aruna-rov/Apsu/schematic/wire/wire.png

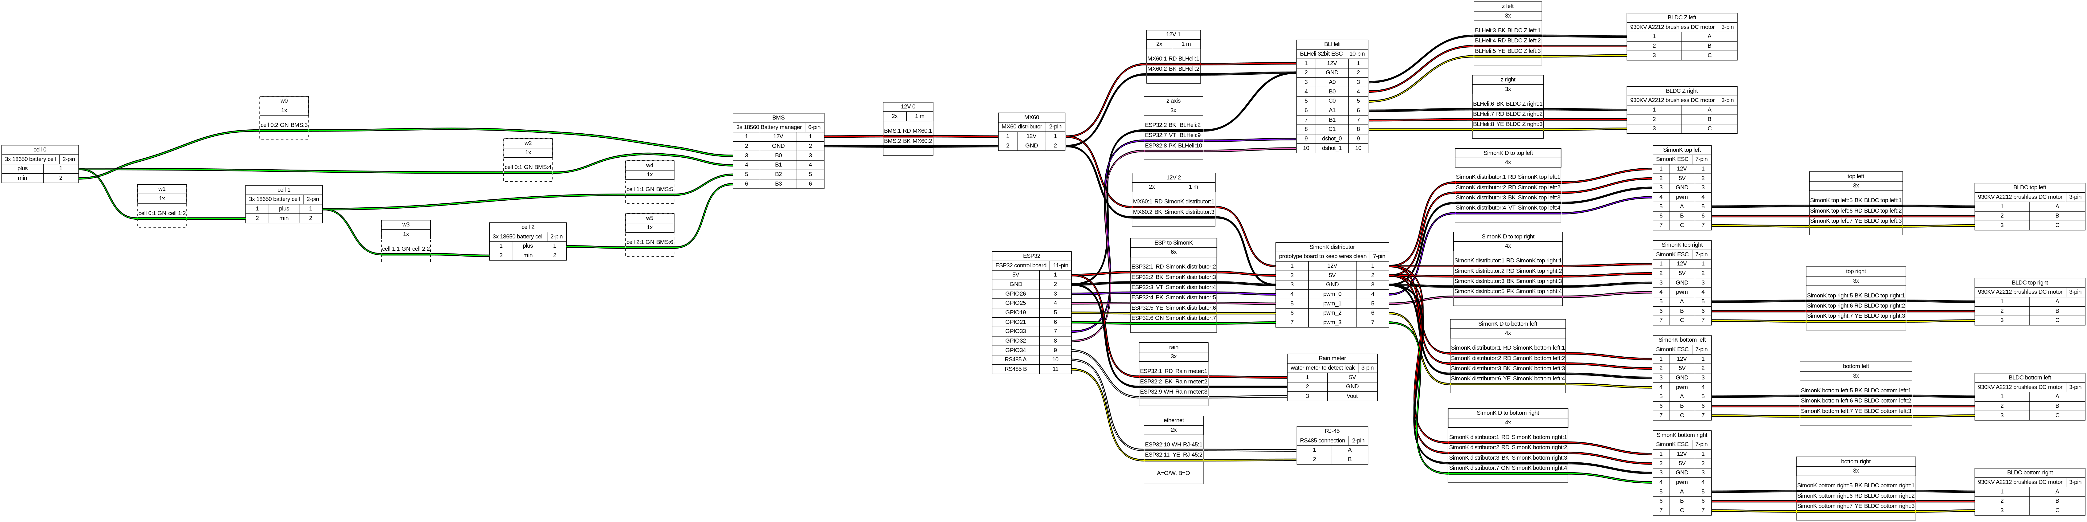
schematic/wire/wire.png
