aruna-rov/Apsu/(list of files, cad)

Other CAD files:
schematic/pcb_design/pcb_design.FCStd
