aruna-rov/Apsu/schematic/Apsu.kicad_pcb

## KiCad design schematic/Apsu.kicad_pcb (2020-08-03)

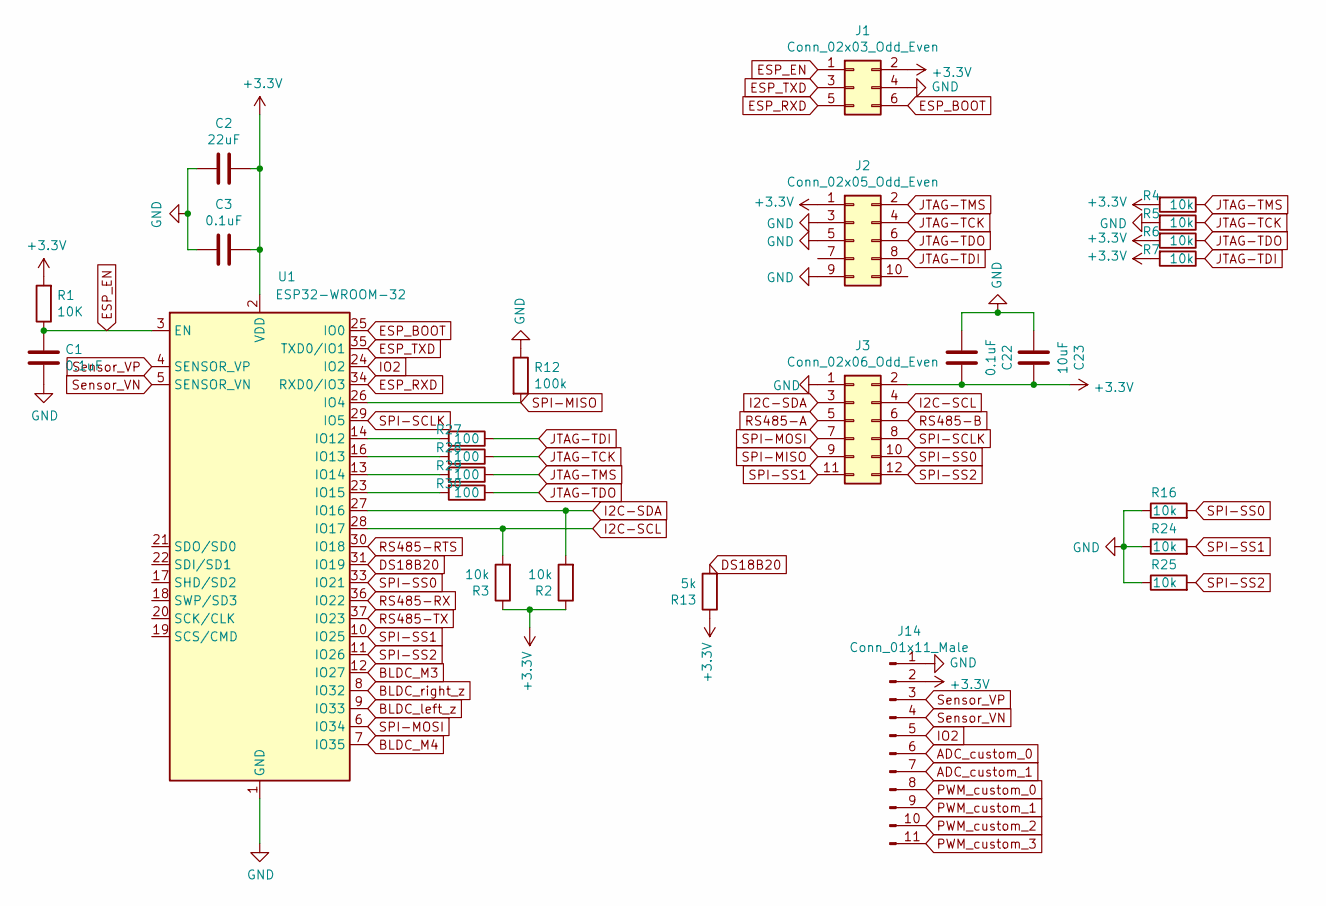
[picture p2: schematic ESP32_module.sch]

Parts:
C1, C3, C22: 0.1uF; C_0805_2012Metric_Pad1.15x1.40mm_HandSolder; MPN C0805C104J5RACTU
C2: 22uF; C_0805_2012Metric_Pad1.15x1.40mm_HandSolder; MPN C0805C226K9PACTU
C23: 10uF; C_0805_2012Metric_Pad1.15x1.40mm_HandSolder; MPN C0805C106K8PACTU
J1: Conn_02x03_Odd_Even; PinHeader_2x03_P1.27mm_Vertical_IDC; MPN GRPB032VWVN-RC
J2: Conn_02x05_Odd_Even; 10pin1.27mmIDC; MPN 3220-10-0100-00
J3: Conn_02x06_Odd_Even; IDC-Header_2x06_P2.54mm_Vertical; MPN BHR-12-VUA
J14: Conn_01x11_Male; PinHeader_1x11_P2.54mm_Vertical
R1: 10K; R_0805_2012Metric_Pad1.15x1.40mm_HandSolder; MPN ERA-6AEB103V
R2, R3, R4, R5, R6, R7, R16, R24, R25: 10k; R_0805_2012Metric_Pad1.15x1.40mm_HandSolder; MPN ERA-6AEB103V
R12: 100k; R_0805_2012Metric_Pad1.15x1.40mm_HandSolder; MPN ERA-6AEB104V
R13: 5k; R_0805_2012Metric_Pad1.15x1.40mm_HandSolder; MPN ERA6AEB4991V
R27, R28, R29, R30: 100; R_0805_2012Metric_Pad1.15x1.40mm_HandSolder; MPN ERA6AEB101V
U1: ESP32-WROOM-32; MPN ESP32-WROOM-32D

Connections:
+3V3: C2.2, C3.2, C22.2, C23.2, J1.2, J2.1, J3.2, J14.2, R1.2, R2.1, R3.1, R4.2, R6.2, R7.2, R13.1, U1.2 (VDD); also elsewhere on the board
ADC_custom_0: J14.6; also elsewhere on the board
ADC_custom_1: J14.7; also elsewhere on the board
BLDC_M3: U1.12 (IO27); also elsewhere on the board
BLDC_M4: U1.7 (IO35); also elsewhere on the board
BLDC_left_z: U1.9 (IO33); also elsewhere on the board
BLDC_right_z: U1.8 (IO32); also elsewhere on the board
DS18B20: R13.2, U1.31 (IO19); also elsewhere on the board
ESP_BOOT: J1.6, U1.25 (IO0)
ESP_EN: C1.1, J1.1, R1.1, U1.3 (EN)
ESP_RXD: J1.5, U1.34 (RXD0/IO3)
ESP_TXD: J1.3, U1.35 (TXD0/IO1)
GND: C1.2, C2.1, C3.1, C22.1, C23.1, J1.4, J2.3, J2.5, J2.9, J3.1, J14.1, R5.2, R12.1, R16.1, R24.1, R25.1, U1.1 (GND), U1.15 (GND), U1.38 (GND), U1.39 (GND); also elsewhere on the board
I2C-SCL: J3.4, R3.2, U1.28 (IO17); also elsewhere on the board
I2C-SDA: J3.3, R2.2, U1.27 (IO16); also elsewhere on the board
IO2: J14.5, U1.24 (IO2)
JTAG-TCK: J2.4, R5.1, R28.1
JTAG-TDI: J2.8, R7.1, R27.1
JTAG-TDO: J2.6, R6.1, R30.1
JTAG-TMS: J2.2, R4.1, R29.1
unnamed: R27.2, U1.14 (IO12)
unnamed: R28.2, U1.16 (IO13)
unnamed: R29.2, U1.13 (IO14)
unnamed: R30.2, U1.23 (IO15)
PWM_custom_0: J14.8; also elsewhere on the board
PWM_custom_1: J14.9; also elsewhere on the board
PWM_custom_2: J14.10; also elsewhere on the board
PWM_custom_3: J14.11; also elsewhere on the board
RS485-A: J3.5; also elsewhere on the board
RS485-B: J3.6; also elsewhere on the board
RS485-RTS: U1.30 (IO18); also elsewhere on the board
RS485-RX: U1.36 (IO22); also elsewhere on the board
RS485-TX: U1.37 (IO23); also elsewhere on the board
SPI-MISO: J3.9, R12.2, U1.26 (IO4); also elsewhere on the board
SPI-MOSI: J3.7, U1.6 (IO34)
SPI-SCLK: J3.8, U1.29 (IO5); also elsewhere on the board
SPI-SS0: J3.10, R16.2, U1.33 (IO21); also elsewhere on the board
SPI-SS1: J3.11, R24.2, U1.10 (IO25); also elsewhere on the board
SPI-SS2: J3.12, R25.2, U1.11 (IO26); also elsewhere on the board
Sensor_VN: J14.4, U1.5 (SENSOR_VN)
Sensor_VP: J14.3, U1.4 (SENSOR_VP)

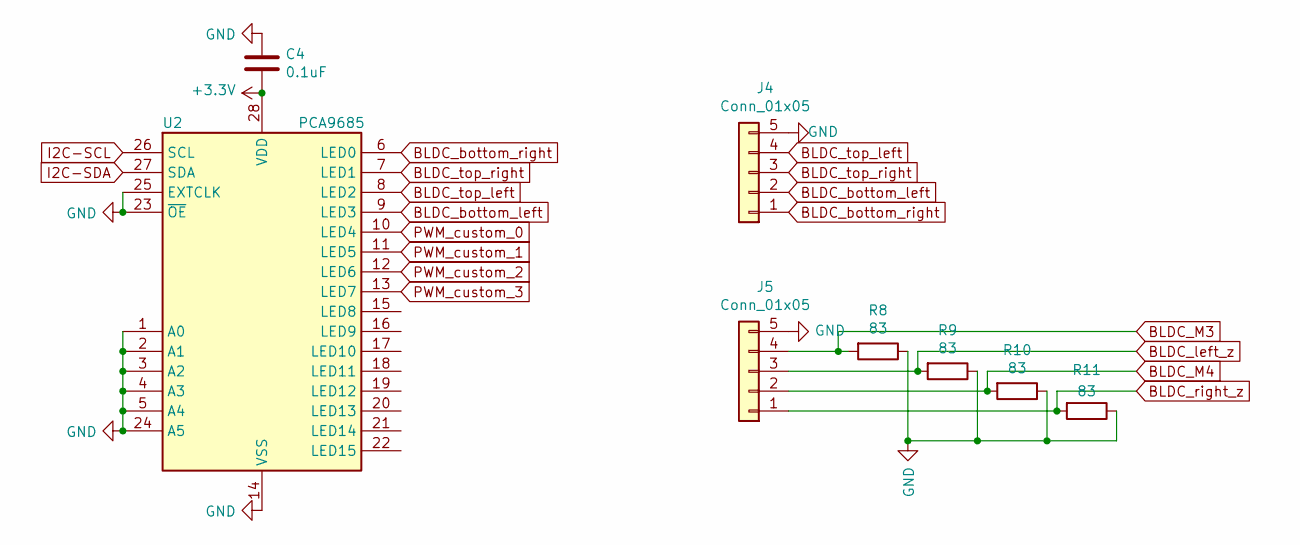
[picture p3: schematic moter.sch]

Parts:
C4: 0.1uF; C_0805_2012Metric_Pad1.15x1.40mm_HandSolder; MPN C0805C104J5RACTU
J4, J5: Conn_01x05; JST_XH_B5B-XH-A_1x05_P2.50mm_Vertical; MPN B5B-XH-A(LF)(SN)
R8, R9, R10, R11: 83; R_0805_2012Metric_Pad1.15x1.40mm_HandSolder; MPN ERA-6AEB820V
U2: PCA9685; NXP_Semiconductors-SOT788-1-02_2016-0-MFG; MPN PCA9685BS,118

Connections:
+3V3: C4.2, U2.28 (VDD); also elsewhere on the board
BLDC_M3: J5.4, R8.2; also elsewhere on the board
BLDC_M4: J5.2, R10.2; also elsewhere on the board
BLDC_bottom_left: J4.2, U2.9 (LED3)
BLDC_bottom_right: J4.1, U2.6 (LED0)
BLDC_left_z: J5.3, R9.2; also elsewhere on the board
BLDC_right_z: J5.1, R11.2; also elsewhere on the board
BLDC_top_left: J4.4, U2.8 (LED2)
BLDC_top_right: J4.3, U2.7 (LED1)
GND: C4.1, J4.5, J5.5, R8.1, R9.1, R10.1, R11.1, U2.1 (A0), U2.2 (A1), U2.3 (A2), U2.4 (A3), U2.5 (A4), U2.14 (VSS), U2.23 (~OE), U2.24 (A5), U2.25 (EXTCLK); also elsewhere on the board
I2C-SCL: U2.26 (SCL); also elsewhere on the board
I2C-SDA: U2.27 (SDA); also elsewhere on the board
PWM_custom_0: U2.10 (LED4); also elsewhere on the board
PWM_custom_1: U2.11 (LED5); also elsewhere on the board
PWM_custom_2: U2.12 (LED6); also elsewhere on the board
PWM_custom_3: U2.13 (LED7); also elsewhere on the board

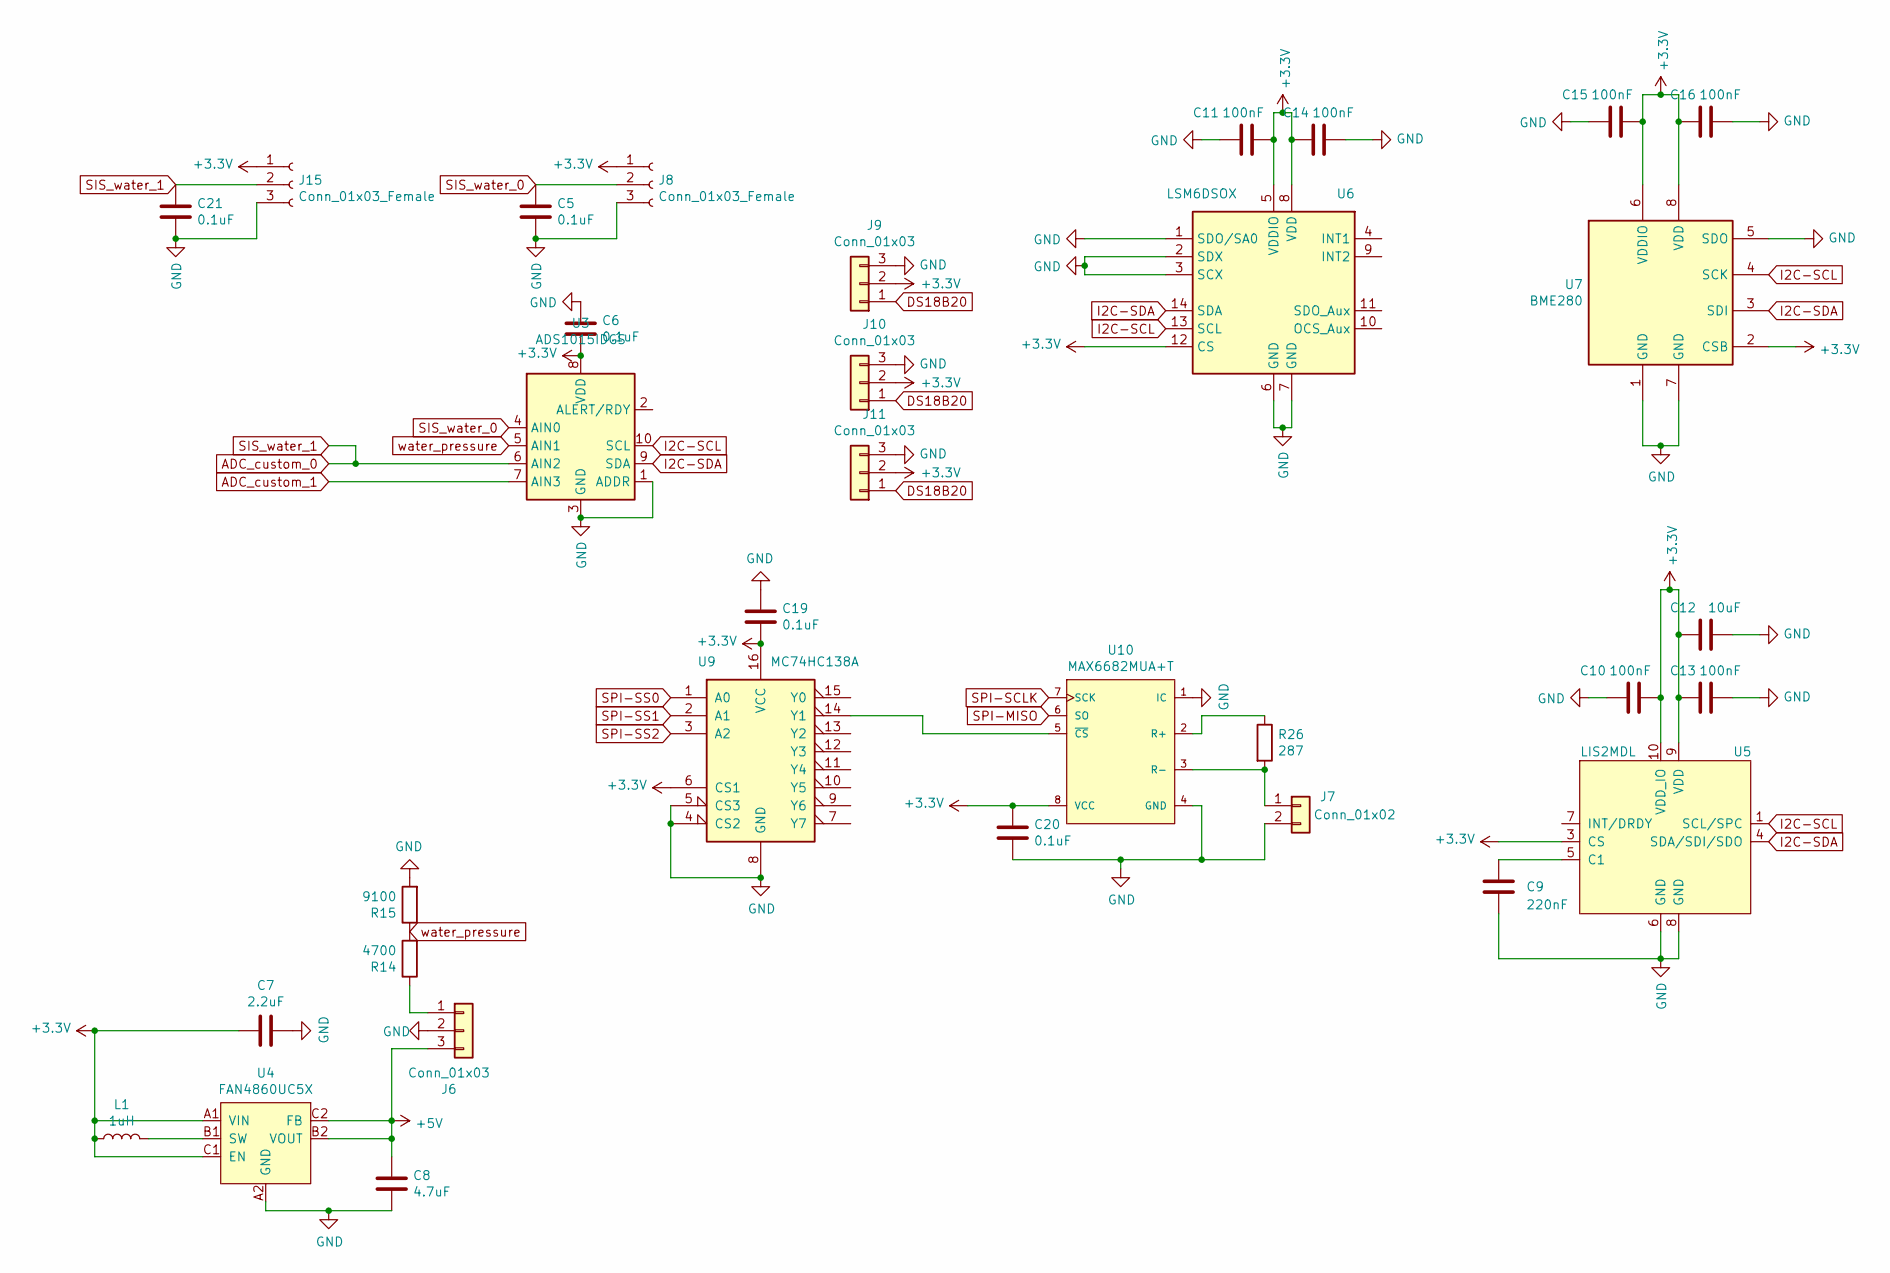
[picture p4: schematic sensors.sch]

Parts:
C5, C6, C19, C20, C21: 0.1uF; C_0805_2012Metric_Pad1.15x1.40mm_HandSolder; MPN C0805C104J5RACTU
C7: 2.2uF; C_0805_2012Metric_Pad1.15x1.40mm_HandSolder; MPN C0805C225K4RACTU
C8: 4.7uF; C_0805_2012Metric_Pad1.15x1.40mm_HandSolder; MPN C0805C475K3PACTU
C9: 220nF; C_0805_2012Metric_Pad1.15x1.40mm_HandSolder; MPN C0805C224K5RACTU
C10, C11, C13, C14, C15, C16: 100nF; C_0805_2012Metric_Pad1.15x1.40mm_HandSolder; MPN C0805C104J5RACTU
C12: 10uF; C_0805_2012Metric_Pad1.15x1.40mm_HandSolder; MPN C0805C106K8PACTU
J6, J9, J10, J11: Conn_01x03; JST_XH_B3B-XH-A_1x03_P2.50mm_Vertical; MPN B3B-XH-A(LF)(SN)
J7: Conn_01x02; JST_XH_B2B-XH-A_1x02_P2.50mm_Vertical; MPN B2B-XH-A(LF)(SN)
J8, J15: Conn_01x03_Female; JST_XH_B3B-XH-A_1x03_P2.50mm_Vertical; MPN B3B-XH-A(LF)(SN)
L1: 1uH; L_0805_2012Metric_Pad1.15x1.40mm_HandSolder; MPN LQM21NN1R0K10D
R14: 4700; R_0805_2012Metric_Pad1.15x1.40mm_HandSolder; MPN ERA-6AEB472V
R15: 9100; R_0805_2012Metric_Pad1.15x1.40mm_HandSolder; MPN ERA6AEB912V
R26: 287; R_0805_2012Metric_Pad1.15x1.40mm_HandSolder; MPN ERA-6AEB301V
U3: ADS1015IDGS; TSSOP-10_3x3mm_P0.5mm; MPN ADS1015IDGS
U4: FAN4860UC5X; WLCSP-6_1.4x1.0mm_P0.4mm; MPN FAN4860UC5X
U5: LIS2MDL; LGA-12_2x2mm_P0.5mm; MPN LIS2MDLTR
U6: LSM6DSOX; LGA-14_3x2.5mm_P0.5mm_LayoutBorder3x4y; MPN LSM6DSOXTR
U7: BME280; Bosch_LGA-8_2.5x2.5mm_P0.65mm_ClockwisePinNumbering; MPN BME280
U9: MC74HC138A; TSSOP-16_4.4x5mm_P0.65mm; MPN MC74HC138ADTR2G
U10: MAX6682MUA+T; Maxim-MAX6682MUA+T-Level_A; MPN MAX6682MUA+T

Connections:
+3V3: C6.2, C7.2, C10.2, C11.2, C12.1, C13.1, C14.1, C15.2, C16.1, C19.2, C20.1, J8.1, J9.2, J10.2, J11.2, J15.1, L1.1, U3.8 (VDD), U4.A1 (VIN), U4.C1 (EN), U5.3 (CS), U5.9 (VDD), U5.10 (VDD_IO), U6.5 (VDDIO), U6.8 (VDD), U6.12 (CS), U7.2 (CSB), U7.6 (VDDIO), U7.8 (VDD), U9.6 (CS1), U9.16 (VCC), U10.8 (VCC); also elsewhere on the board
+5V: C8.1, J6.3, U4.B2 (VOUT), U4.C2 (FB)
ADC_custom_0: C21.1, J15.2, U3.6 (AIN2); also elsewhere on the board
ADC_custom_1: U3.7 (AIN3); also elsewhere on the board
DS18B20: J9.1, J10.1, J11.1; also elsewhere on the board
GND: C5.2, C6.1, C7.1, C8.2, C9.2, C10.1, C11.1, C12.2, C13.2, C14.2, C15.1, C16.2, C19.1, C20.2, C21.2, J6.2, J7.2, J8.3, J9.3, J10.3, J11.3, J15.3, R15.2, U3.1 (ADDR), U3.3 (GND), U4.A2 (GND), U5.6 (GND), U5.8 (GND), U6.1 (SDO/SA0), U6.2 (SDX), U6.3 (SCX), U6.6 (GND), U6.7 (GND), U7.1 (GND), U7.5 (SDO), U7.7 (GND), U9.4 (CS2), U9.5 (CS3), U9.8 (GND), U10.1 (IC), U10.4 (GND); also elsewhere on the board
I2C-SCL: U3.10 (SCL), U5.1 (SCL/SPC), U6.13 (SCL), U7.4 (SCK); also elsewhere on the board
I2C-SDA: U3.9 (SDA), U5.4 (SDA/SDI/SDO), U6.14 (SDA), U7.3 (SDI); also elsewhere on the board
unnamed: C9.1, U5.5 (C1)
unnamed: J6.1, R14.1
unnamed: J7.1, R26.2, U10.3 (R-)
unnamed: L1.2, U4.B1 (SW)
unnamed: R26.1, U10.2 (R+)
unnamed: U9.14 (Y1), U10.5 (~CS~)
SIS_water_0: C5.1, J8.2, U3.4 (AIN0)
SPI-MISO: U10.6 (SO); also elsewhere on the board
SPI-SCLK: U10.7 (SCK); also elsewhere on the board
SPI-SS0: U9.1 (A0); also elsewhere on the board
SPI-SS1: U9.2 (A1); also elsewhere on the board
SPI-SS2: U9.3 (A2); also elsewhere on the board
water_pressure: R14.2, R15.1, U3.5 (AIN1)

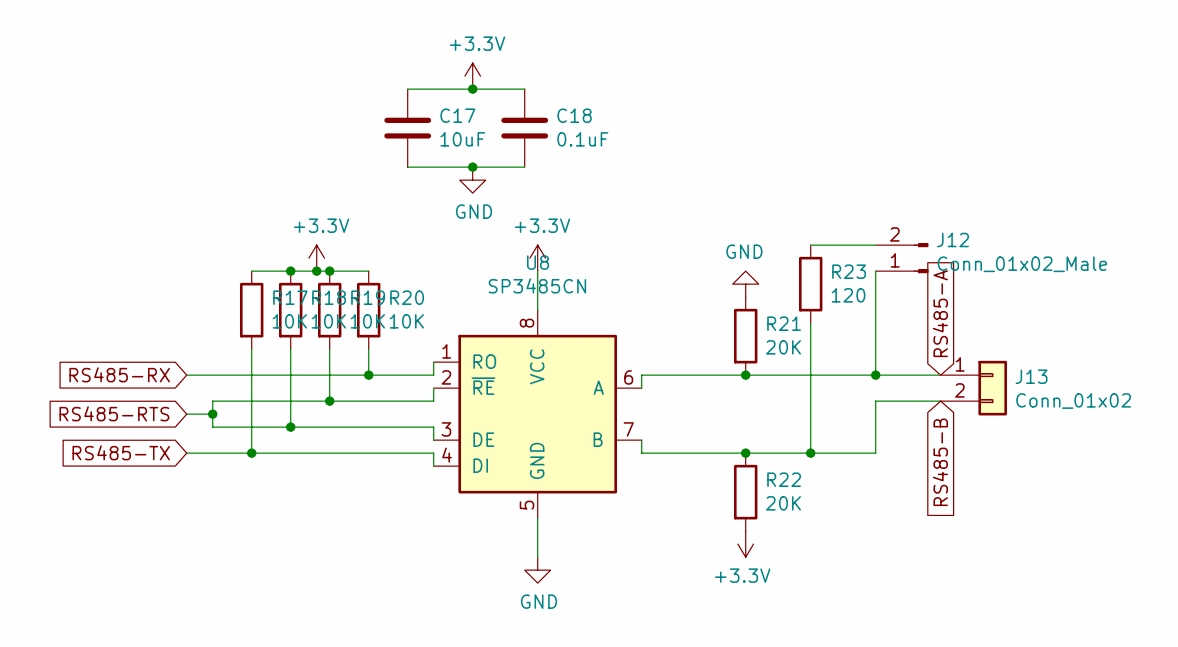
[picture p5: schematic communication.sch]

Parts:
C17: 10uF; C_0805_2012Metric_Pad1.15x1.40mm_HandSolder; MPN C0805C106K8PACTU
C18: 0.1uF; C_0805_2012Metric_Pad1.15x1.40mm_HandSolder; MPN C0805C104J5RACTU
J12: Conn_01x02_Male; PinHeader_1x02_P2.54mm_Vertical
J13: Conn_01x02; JST_XH_B2B-XH-A_1x02_P2.50mm_Vertical; MPN B2B-XH-A(LF)(SN)
R17, R18, R19, R20: 10K; R_0805_2012Metric_Pad1.15x1.40mm_HandSolder; MPN ERA-6AEB103V
R21, R22: 20K; R_0805_2012Metric_Pad1.15x1.40mm_HandSolder; MPN ERA6AEB203V
R23: 120; R_0805_2012Metric_Pad1.15x1.40mm_HandSolder; MPN ERJ-6ENF1200V
U8: SP3485CN; SOIC-8_3.9x4.9mm_P1.27mm; MPN MAX485CSA+

Connections:
+3V3: C17.1, C18.1, R17.1, R18.1, R19.1, R20.1, R22.2, U8.8 (VCC); also elsewhere on the board
GND: C17.2, C18.2, R21.1, U8.5 (GND); also elsewhere on the board
unnamed: J12.2, R23.1
RS485-A: J12.1, J13.1, R21.2, U8.6 (A); also elsewhere on the board
RS485-B: J13.2, R22.1, R23.2, U8.7 (B); also elsewhere on the board
RS485-RTS: R18.2, R19.2, U8.2 (~RE~), U8.3 (DE); also elsewhere on the board
RS485-RX: R20.2, U8.1 (RO); also elsewhere on the board
RS485-TX: R17.2, U8.4 (DI); also elsewhere on the board

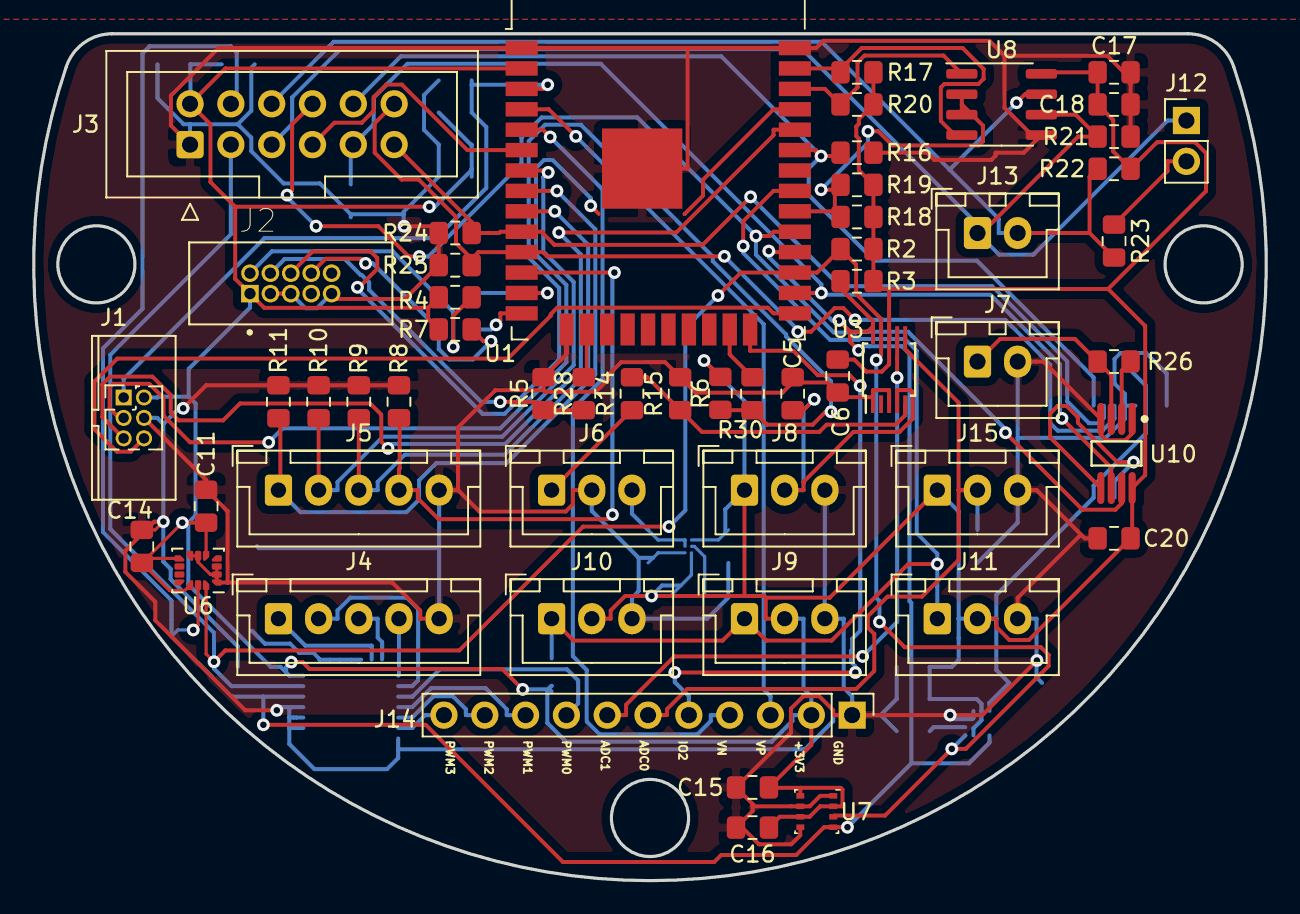
[picture p6: board Apsu.kicad_pcb from above]

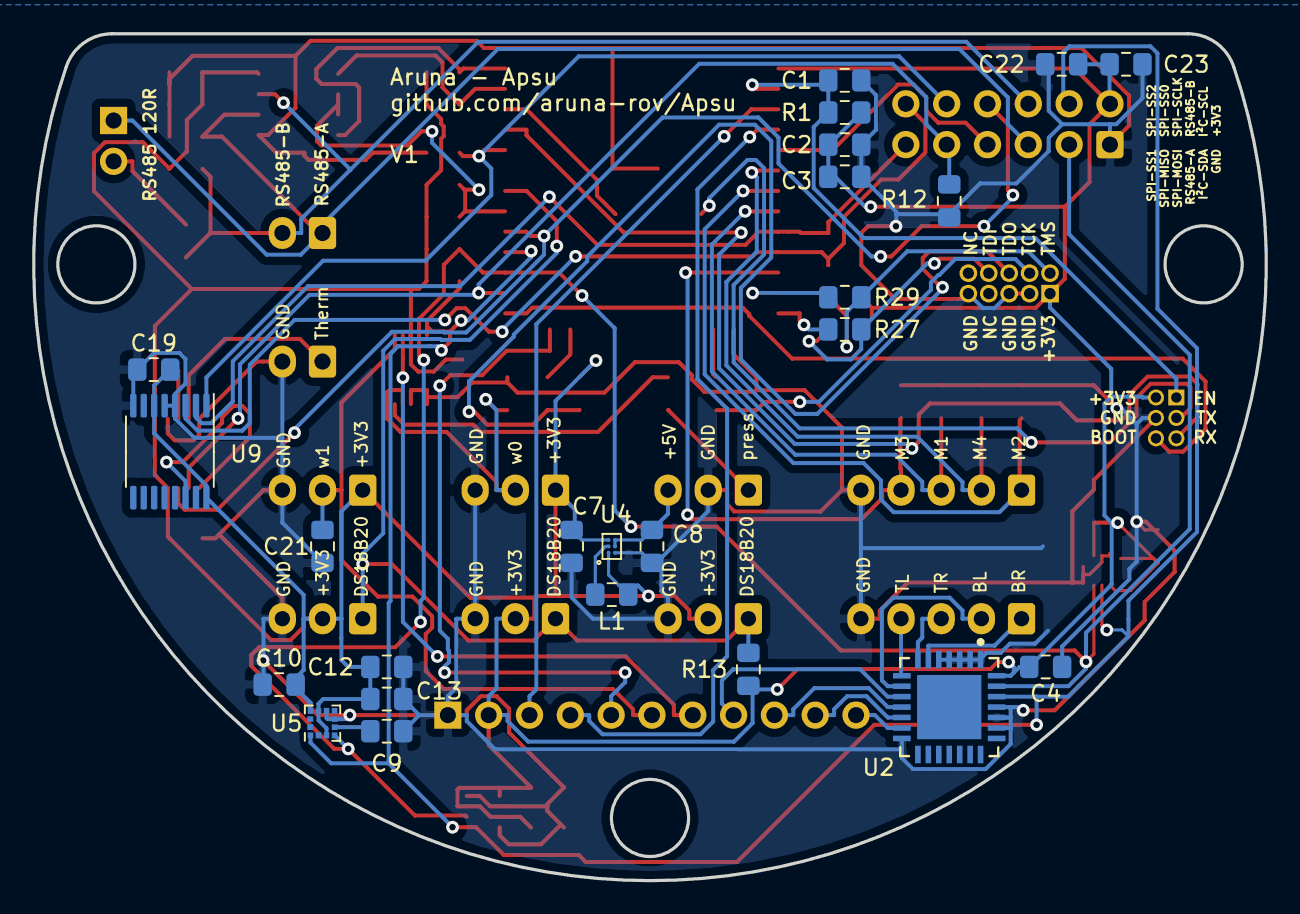
[picture p7: board Apsu.kicad_pcb from below]

Board: 2 copper layers, 76.7 x 52.7 mm, 79 parts (24 on the bottom side), 55 nets.
