aruna-rov/Apsu/schematic/power.kicad_pcb

## KiCad design schematic/power.kicad_pcb (2020-08-03)

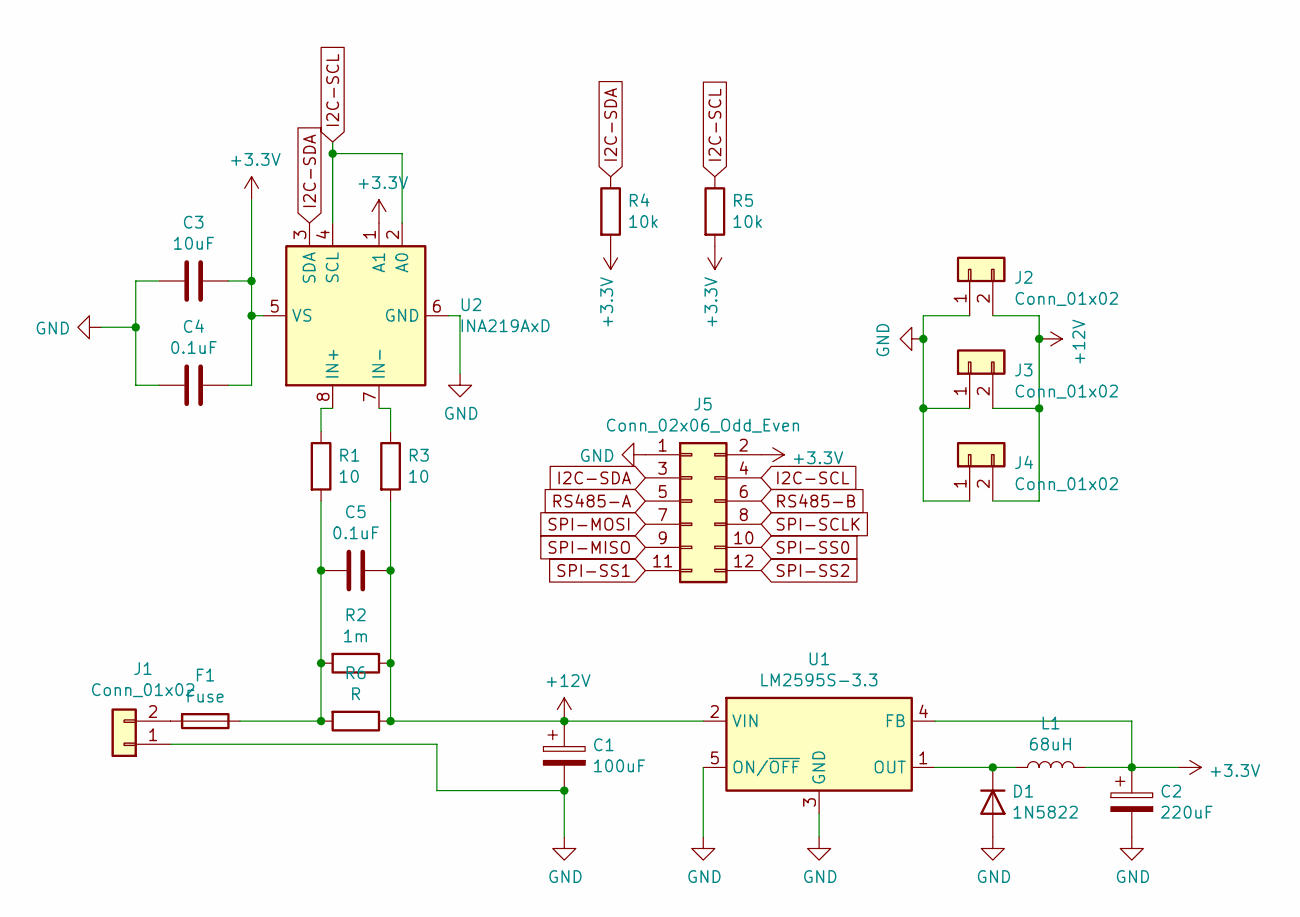
[picture p8: schematic power.sch, Apsu Power]

Parts:
C1: 100uF; CP_Radial_D10.0mm_P5.00mm; MPN EEUTP1V101
C2: 220uF; CP_Radial_D8.0mm_P3.50mm; MPN ESW227M035AG4AA
C3: 10uF; C_0805_2012Metric_Pad1.15x1.40mm_HandSolder; MPN C0805C106K8PACTU
C4, C5: 0.1uF; C_0805_2012Metric_Pad1.15x1.40mm_HandSolder; MPN C0805C104J5RACTU
D1: 1N5822; D_DO-201AD_P15.24mm_Horizontal; MPN 1N5822
F1: Fuse; Fuseholder_Cylinder-5x20mm_Schurter_0031_8201_Horizontal_Op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
J1: Conn_01x02; AMASS_XT60-M_1x02_P7.20mm_Vertical; MPN PRT-10474
J2, J3, J4: Conn_01x02; AMASS_XT60-F_1x02_P7.20mm_Vertical; MPN PRT-10474
J5: Conn_02x06_Odd_Even; IDC-Header_2x06_P2.54mm_Vertical; MPN BHR-12-VUA
L1: 68uH; L_Radial_L16.1mm_W16.1mm_Px7.62mm_Py12.70mm_Pulse_LP-44; MPN PE-53830NL
R1, R3: 10; R_0805_2012Metric_Pad1.15x1.40mm_HandSolder; MPN ERJ-P06J100V
R2: 1m; R_2512_6332Metric_Pad1.52x3.35mm_HandSolder; MPN CSNL2512FT1L00
R4, R5: 10k; R_0805_2012Metric_Pad1.15x1.40mm_HandSolder; MPN ERA-6AEB103V
R6: R; R_Axial_DIN0207_L6.3mm_D2.5mm_P10.16mm_Horizontal
U1: LM2595S-3.3; TO-263-5_TabPin3; MPN LM2595S-3.3/NOPB
U2: INA219AxD; SOIC-8_3.9x4.9mm_P1.27mm; MPN INA219AIDR

Connections:
+3V3: C2.1, C3.1, C4.1, J5.2, L1.2, R4.2, R5.2, U1.4 (FB), U2.1 (A1), U2.5 (VS)
+12V: C1.1, C5.1, J2.2, J3.2, J4.2, R2.1, R3.2, R6.1, U1.2 (VIN)
GND: C1.2, C2.2, C3.2, C4.2, D1.2 (A), J1.1, J2.1, J3.1, J4.1, J5.1, U1.3 (GND), U1.5 (ON/~OFF), U2.6 (GND)
I2C-SCL: J5.4, R5.1, U2.2 (A0), U2.4 (SCL)
I2C-SDA: J5.3, R4.1, U2.3 (SDA)
unnamed: C5.2, F1.1, R1.2, R2.2, R6.2
unnamed: D1.1 (K), L1.1, U1.1 (OUT)
unnamed: F1.2, J1.2
unnamed: R1.1, U2.8 (IN+)
unnamed: R3.1, U2.7 (IN-)
RS485-A: J5.5
RS485-B: J5.6
SPI-MISO: J5.9
SPI-MOSI: J5.7
SPI-SCLK: J5.8
SPI-SS0: J5.10
SPI-SS1: J5.11
SPI-SS2: J5.12

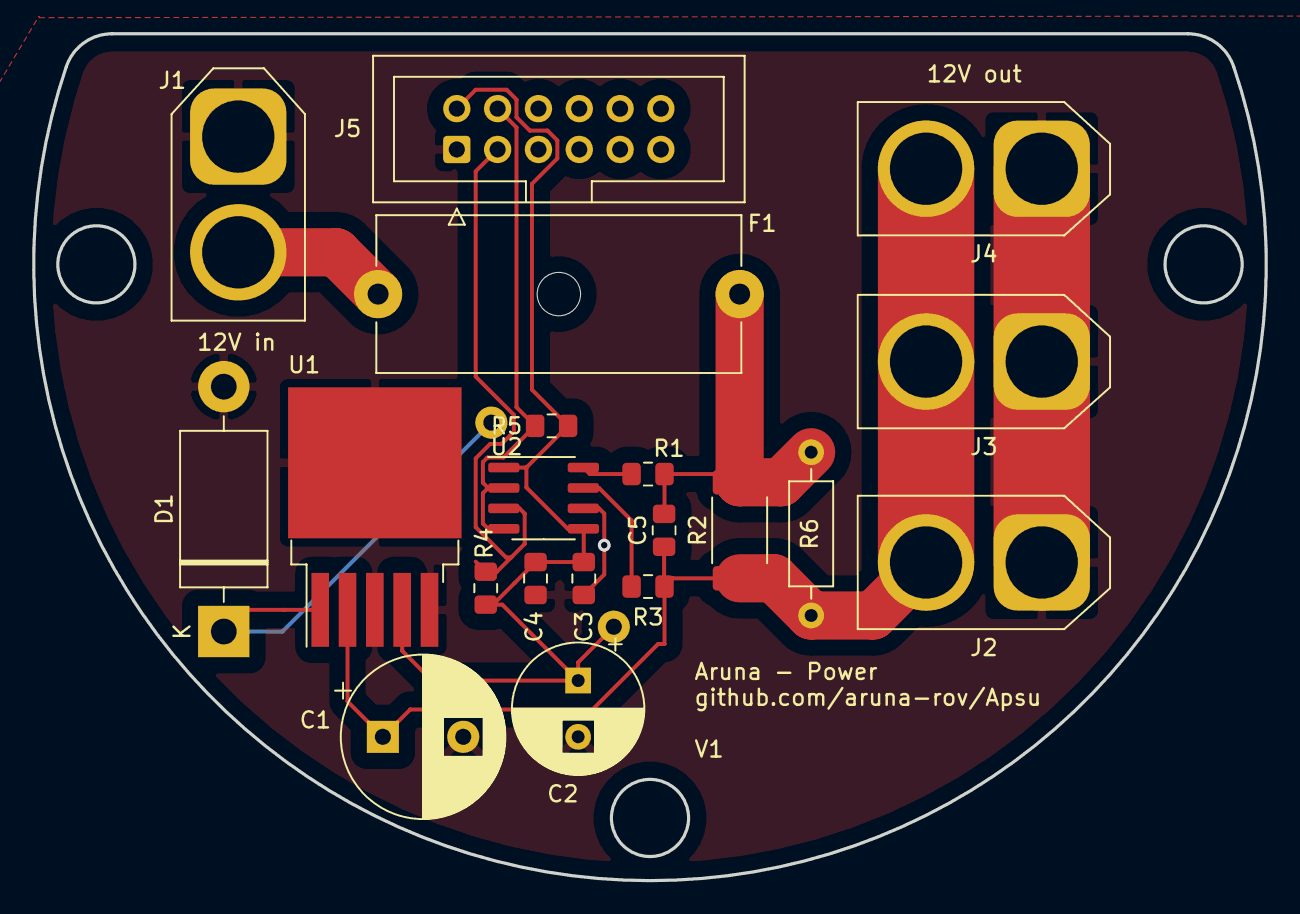
[picture p9: board power.kicad_pcb from above]

Board: 2 copper layers, 76.7 x 52.7 mm, 21 parts (1 on the bottom side), 10 nets.
