aruna-rov/Apsu/(commit log)

2019-11-06 added bldc motors
2020-01-04 Put bldc motors in off modes
2020-03-30 removed unused drivers
2020-03-30 Dshot Z drivers
2020-04-26 pwm startup fix
2020-04-26 removed MPU driver
2020-05-14 Apsu schematic init
    [Apsu.kicad_pcb, Apsu.sch]
2020-05-19 prototype board state
    [Apsu.sch]
2020-05-19 more connectors
    [Apsu.sch]
2020-05-22 SIS water to I2C and added SPI
    [Apsu.sch]
2020-05-22 SimonK BLDC to I2C -> PWM
    [Apsu.sch]
2020-05-22 added DS18B20 conn
    [Apsu.sch]
2020-05-23 voltage divider
    [Apsu.sch]
2020-05-31 moved everything in seperated schematics
    [Apsu.sch, ESP32_module.sch, communication.sch, moter.sch, power.sch, sensors.sch]
2020-05-31 prototype footprint and placement test
    [Apsu.kicad_pcb, ESP32_module.sch, communication.sch, moter.sch, power.sch, sensors.sch]
2020-06-08 added LSM6DSOX and LIS2MDL for IMU
    [Apsu.kicad_pcb, ESP32_module.sch, moter.sch, sensors.sch]
2020-06-10 added BME280
    [sensors.sch]
2020-06-10 added pcb design
    [pcb_design.FCStd]
2020-06-10 new pcb design
    [Apsu.kicad_pcb, communication.sch, moter.sch, sensors.sch]
2020-06-17 SP385 instead of MAX
    [communication.sch]
2020-06-17 Cleared IO2
    [ESP32_module.sch]
2020-06-17 BLHeli pull-down
    [moter.sch]
2020-06-17 SPI SS multiplex concept
    [ESP32_module.sch]
2020-06-17 power on seperate board
    [Apsu.kicad_pcb, Apsu.sch, ESP32_module.sch, communication.sch, moter.sch, power.kicad_pcb, power.sch, sensors.sch]
2020-06-20 added 5v boost converter
    [ESP32_module.sch, communication.sch, moter.sch, power.sch]
2020-06-24 boost converter on Apsu board and PCB design
    [Apsu.kicad_pcb, communication.sch, moter.sch, power.kicad_pcb, power.sch, sensors.sch]
2020-06-24 added 14pin header
    [Apsu.kicad_pcb, ESP32_module.sch]
2020-06-24 wire documentation
2020-06-25 added MAX6682 for termistor
    [ESP32_module.sch, sensors.sch]
2020-06-26 new components on pcb
    [Apsu.kicad_pcb, ESP32_module.sch, communication.sch, moter.sch, sensors.sch]
2020-07-03 JTAG anti-ring resistors
    [Apsu.kicad_pcb, ESP32_module.sch, moter.sch, power.sch]
2020-07-04 adjusted 1.27mm IDC and PCA9685 to correct footprint
    [Apsu.kicad_pcb, ESP32_module.sch]
2020-07-07 on-pcb documentation
    [Apsu.kicad_pcb]
2020-07-08 added extra resistor, removed unnessesary components and added traces to power board
    [Apsu.kicad_pcb, power.kicad_pcb, power.sch]
2020-07-10 power documentation
    [power.kicad_pcb]
2020-07-11 prototype PCB
    [power.kicad_pcb, power.sch, prototype.kicad_pcb]
2020-07-13 correct power D1, C1, C2 and L1 footprint. accurate L1, D1 and C2 values
    [power.kicad_pcb, power.sch]
2020-07-15 added version
    [Apsu.kicad_pcb, power.kicad_pcb, power.sch]
2020-07-18 added MPN
    [Apsu.kicad_pcb, Apsu.sch, ESP32_module.sch, communication.sch, moter.sch, power.sch, sensors.sch]
2020-08-03 added MPN for connectors
    [Apsu.kicad_pcb, ESP32_module.sch, communication.sch, moter.sch, power.kicad_pcb, power.sch, prototype.kicad_pcb, sensors.sch]
2020-08-03 resistor and capacitor datasheet
2020-09-25 PCA9685 PWM
